team-elektron/WRO-FE-2026/Robot Photos/back.jpg

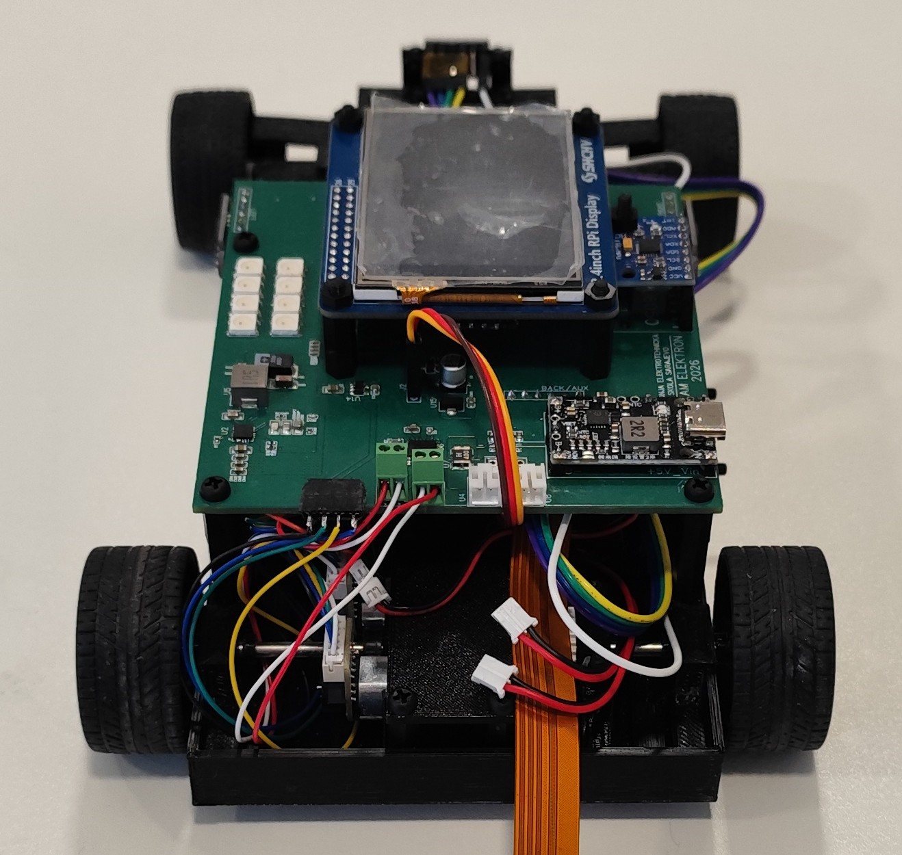
Robot Photos/back.jpg
