team-elektron/WRO-FE-2026/Robot Photos/bottom.jpg

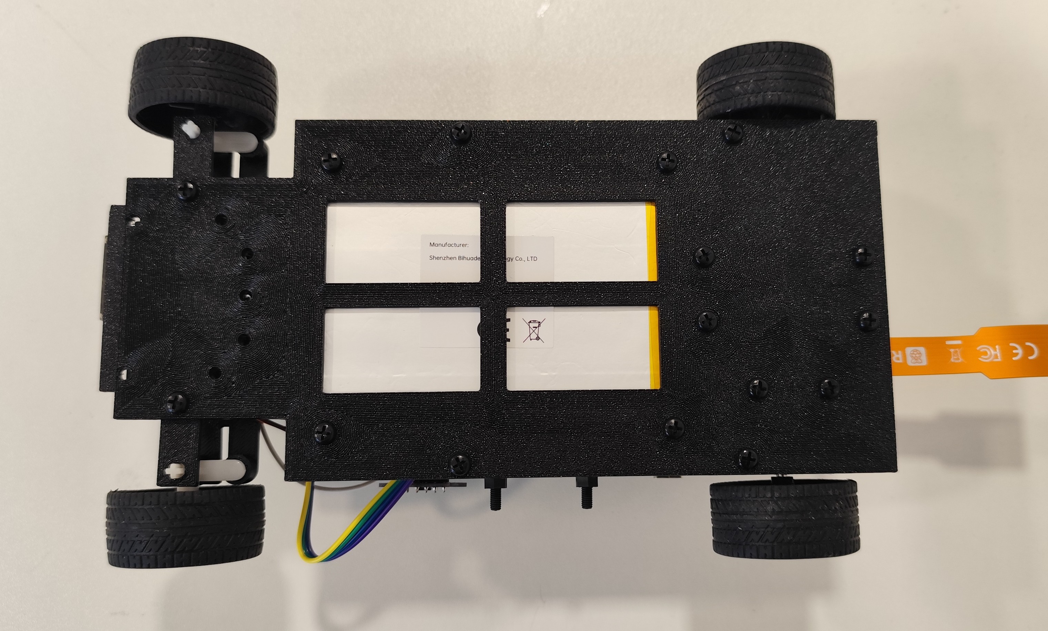
Robot Photos/bottom.jpg
