team-elektron/WRO-FE-2026/Robot Photos/front.jpg

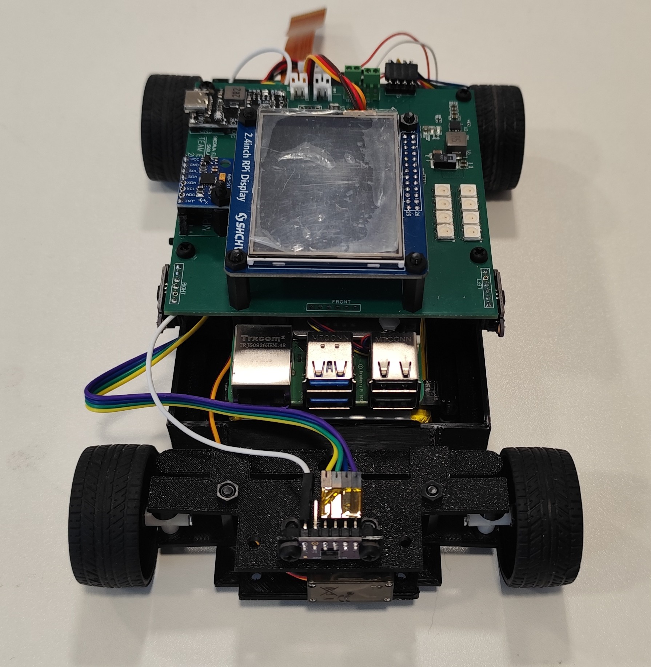
Robot Photos/front.jpg
