team-elektron/WRO-FE-2026/Robot Photos/left.jpg

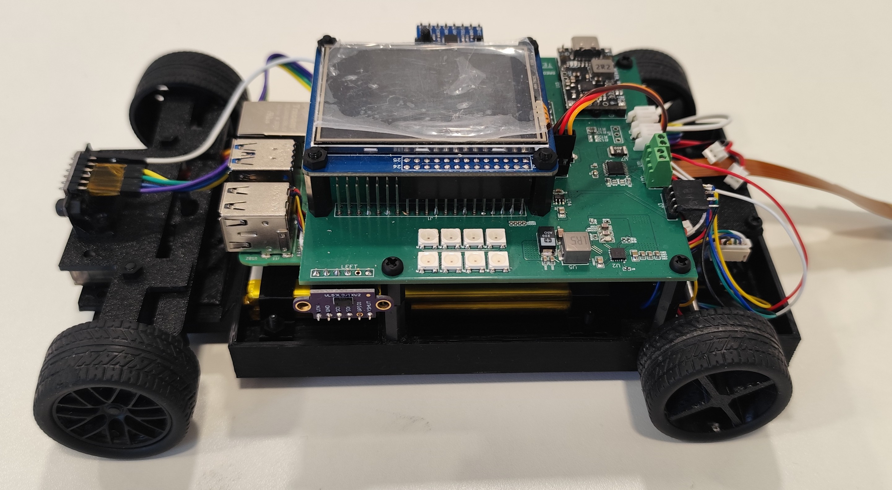
Robot Photos/left.jpg
