team-elektron/WRO-FE-2026/Robot Photos/Pics/3d-design-right.jpg

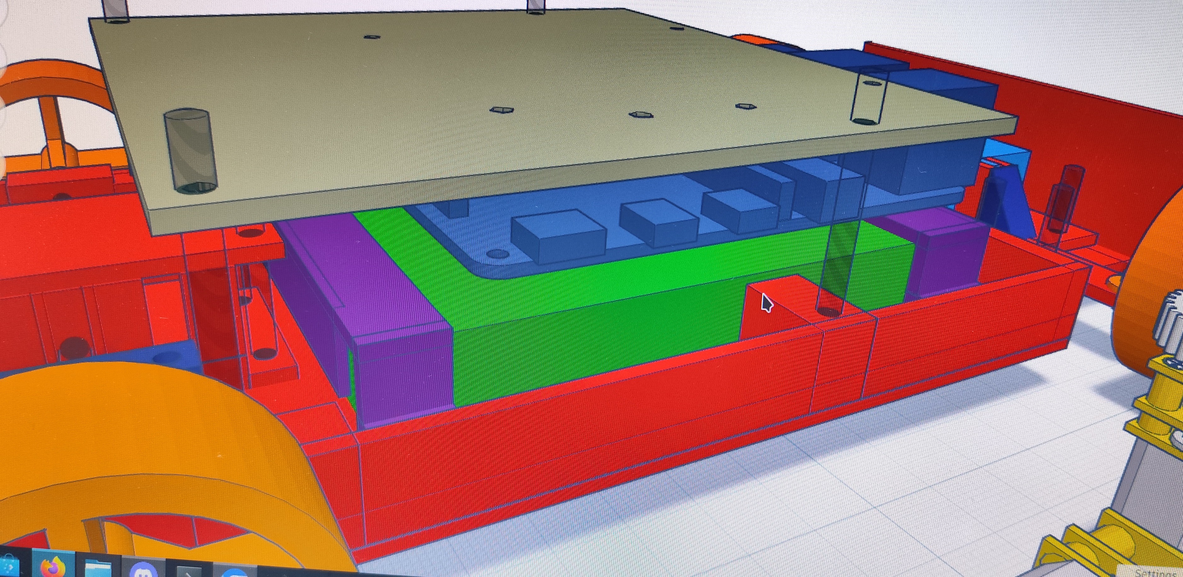
Robot Photos/Pics/3d-design-right.jpg
