team-elektron/WRO-FE-2026/Robot Photos/Pics/bat-chg-prot.png

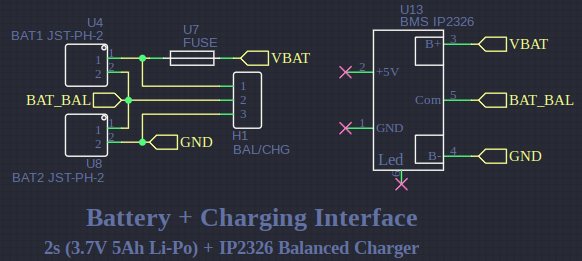
Robot Photos/Pics/bat-chg-prot.png
