team-elektron/WRO-FE-2026/Robot Photos/Pics/IMG_20260430_230106.jpg

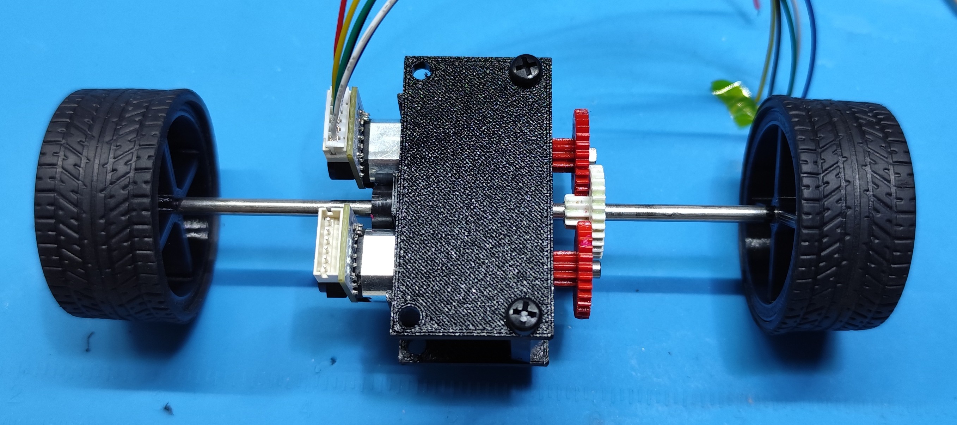
Robot Photos/Pics/IMG_20260430_230106.jpg
