team-elektron/WRO-FE-2026/Robot Photos/Pics/ip2326-and-mpu6050.jpg

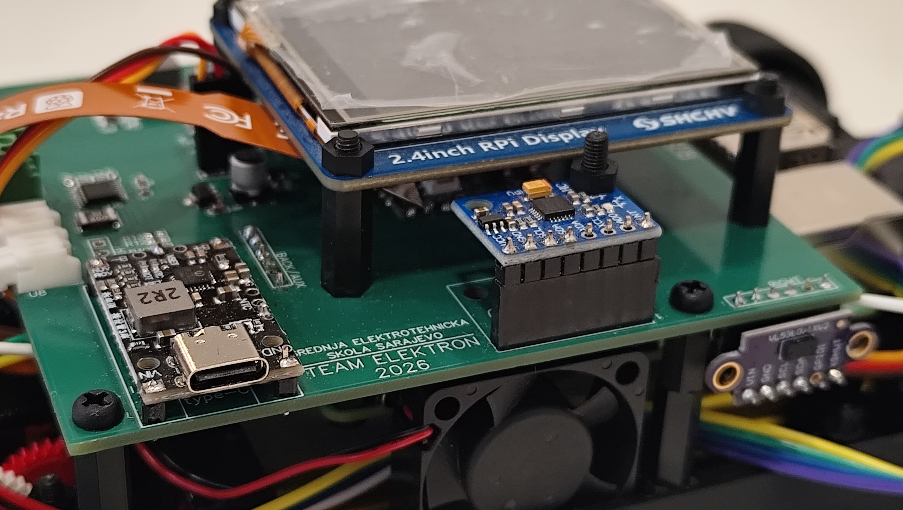
Robot Photos/Pics/ip2326-and-mpu6050.jpg
