team-elektron/WRO-FE-2026/Robot Photos/Pics/raspberry-pi-pico2.jpg

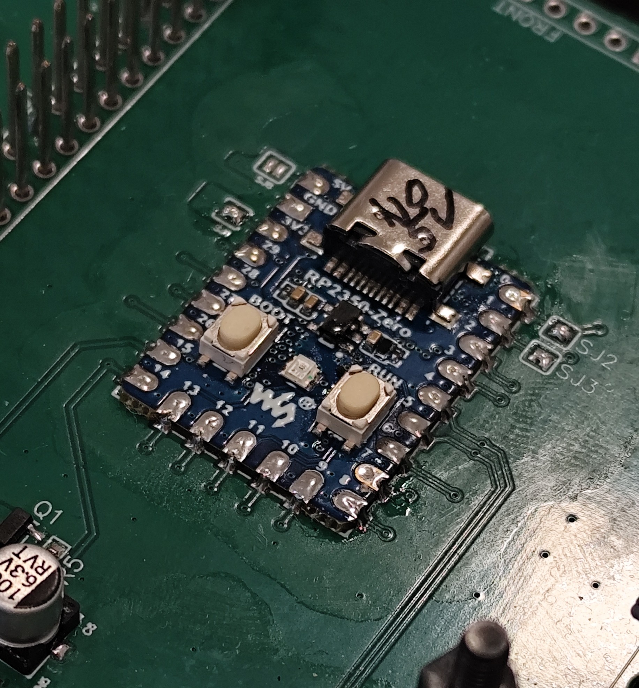
Robot Photos/Pics/raspberry-pi-pico2.jpg
