team-elektron/WRO-FE-2026/Robot Photos/top.jpg

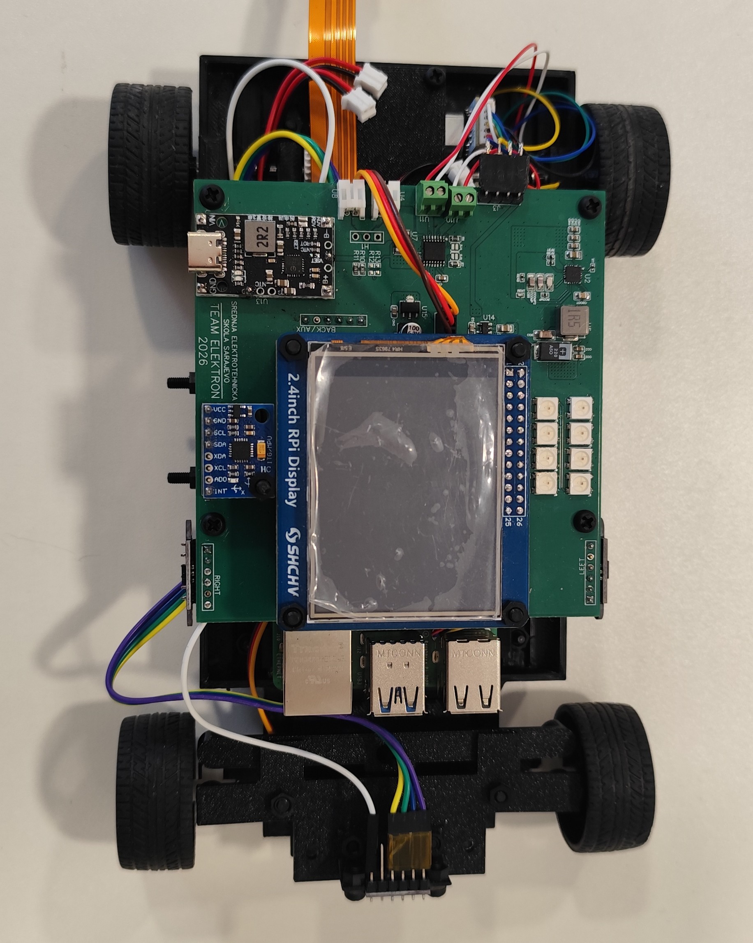
Robot Photos/top.jpg
