team-elektron/WRO-FE-2026/Team Photos/funny.jpg

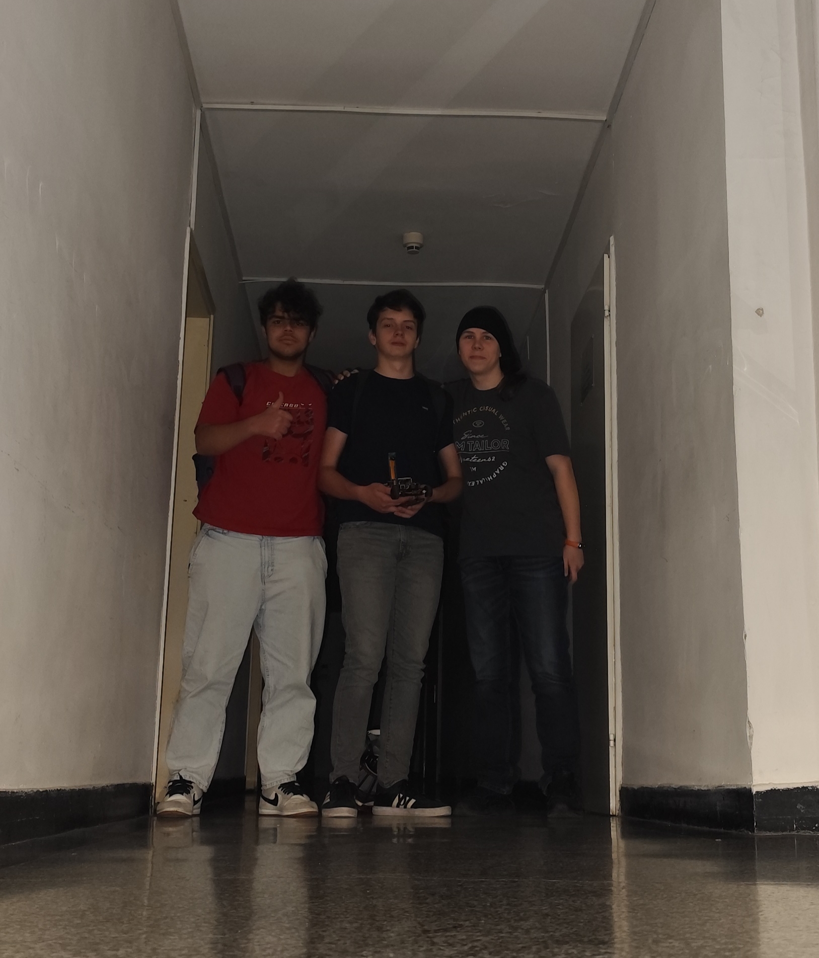
Team Photos/funny.jpg
