team-elektron/WRO-FE-2026/Schematics/BOM_WRO-FE-2026.csv

ID | Name | Designator | Footprint | Quantity | Manufacturer Part | Manufacturer | Supplier | Supplier Part | Price
1 | 105kΩ | RENT | R0402 | 1 | 0402WGF1053TCE | UNI-ROYAL(厚声) | LCSC | C25742 | 0.001
2 | 10kΩ | RFBB | R0402 | 1 | RC0402FR-7W10KL | YAGEO(国巨) | LCSC | C851848 | 0.003
3 | RP2040-ZERO | U3 | COMM-SMD_RP2040-ZERO | 1 | RP2040-Zero | Waveshare(微雪电子) | LCSC | C5350143 | 6.019
4 | ME6118A50PG | U15 | SOT-89-3_L4.5-W2.5-P1.50-LS4.2-BR | 1 | ME6118A50PG | MICRONE(南京微盟) | LCSC | C2835802 | 0.076
5 | AP2112K-3.3TRG1(MS) | U14 | SOT-23-5_L2.9-W1.6-P0.95-LS2.7-BR | 1 | AP2112K-3.3TRG1(MS) | MSKSEMI(美森科) | LCSC | C22365427 | 0.075
6 | BMS IP2326 | U13 | LX-LISC-V1 IP2326 TDA | 1
7 | MOTOR2 | U11 | CONN-TH_DB125-2.54-2P-GN | 1 | DB125-2.54-2P-GN-S | DORABO(地博电气) | LCSC | C918120 | 0.236
8 | MOTOR1 | U10 | CONN-TH_DB125-2.54-2P-GN | 1 | DB125-2.54-2P-GN-S | DORABO(地博电气) | LCSC | C918120 | 0.236
9 | BAT2 JST-PH-2 | U8 | CONN-TH_S2B-PH-K-S-LF-SN | 1 | S2B-PH-K-S(LF)(SN) | JST | LCSC | C173752 | 0.038
10 | FUSE | U7 | F1812 | 1 | BSMD1812-400-12V | BHFUSE(佰宏) | LCSC | C18164540 | 0.132
11 | DRV8833PWP | U6 | TSSOP-16_L5.0-W4.4-P0.65-LS6.4-BL-EP | 1 | DRV8833PWPR | TI(德州仪器) | LCSC | C50506 | 0.924
12 | 1.5uH | U5 | IND-SMD_L7.2-W6.6_GPSR07X0 | 1 | CYA0650-1.5UH | SHOU HAN(首韩) | LCSC | C5189751 | 0.26
13 | BAT1 JST-PH-2 | U4 | CONN-TH_S2B-PH-K-S-LF-SN | 1 | S2B-PH-K-S(LF)(SN) | JST | LCSC | C173752 | 0.038
14 | TPS54623RHLR | U2 | VQFN-14_L3.5-W3.5-P0.50-TL-EP_TPS54622RHLT | 1 |  | TI(德州仪器) | LCSC | C560970 | 0.503
15 | NC | SJ8,SJ3,SJ2 | SJ_2S | 3
16 | NO | SJ5,SJ4,SJ1 | SJ_2S-NO | 3
17 | 53.6kΩ | RT | R0402 | 1 | RC0402FR-0753K6L | YAGEO(国巨) | LCSC | C273330 | 0.001
18 | VL53L0x_3 | RIGHT | HDR-F-2.54_1X6 | 1 |  |  | LCSC | C40877 | 0.088
19 | 75kΩ | RFBT | R0402 | 1 | CRCW040275K0FKED | VISHAY(威世) | LCSC | C482234 | 0.004
20 | 37.4kΩ | RENB | R0402 | 1 | RC0402FR-0737K4L | YAGEO(国巨) | LCSC | C185422 | 0.001
21 | 7.5kΩ | RCOMP | R0402 | 1 | CRCW04027K50FKED | VISHAY(威世) | LCSC | C482236 | 0.004
22 | 10kΩ | R13,R10,R5 | R0603 | 3 | RC0603FR-0710KL | YAGEO(国巨) | LCSC | C98220 | 0.002
23 | 36kΩ | R12,R11 | R0603 | 2 | RC0603FR-0736KL | YAGEO(国巨) | LCSC | C114619 | 0.002
24 | 200mΩ | R7,R6 | R0603 | 2 | RTT03R20JTP | RALEC(旺诠) | LCSC | C158890 | 0.003
25 | IRLML6344 | Q1 | SOT-23-3_L3.0-W1.6-P1.90-LS2.8-BR | 1 | IRLML6344TR(UMW) | UMW(友台半导体) | LCSC | C5271195 | 0.024
26 | VL53L0x_2 | LEFT | HDR-F-2.54_1X6 | 1 |  |  | LCSC | C40877 | 0.088
27 | WS2812E-V5 | LED9,LED8,LED7,LED6,LED5,LED4,LED3,LED2 | LED-SMD_4P-L5.0-W5.0-LS5.4-TL-1 | 8 | WS2812E-V5 | worldsemi | LCSC | C2920042 | 0.064
28 | MOTOR_HALL | J3 | HDR-M-2.54_1X4 | 1 |  |  | LCSC | C124378 | 0.055
29 | SERVO | J2 | HDR-M-2.54_1X3 | 1 |  |  | LCSC | C180248 | 0.214
30 | 40P_GPIO | J1 | HDR-M-2.54_2X20 | 1 |  |  | LCSC | C50980 | 0.224
31 | BAL/CHG | H1 | HDR-F-2.54_1X3 | 1 |  |  | LCSC | C146690 | 0.098
32 | VL53L0x_1 | FRONT | HDR-F-2.54_1X6 | 1 |  |  | LCSC | C40877 | 0.088
33 | 2.2nF | CSS | C0805 | 1 | CL21C222JBFNNNE | SAMSUNG(三星) | LCSC | C28260 | 0.03
34 | 100nF | CO9,CO8,CO7,C10,C2 | C0402 | 5 | CGA0402X7R104K6R3GT | HRE(芯声) | LCSC | C22435938 | 0.001
35 | 100uF | CO6 | C1206 | 1 | TCC1206X5R107M6R3HT | CCTC(三环) | LCSC | C380356 | 0.061
36 | 10uF | CO3,CO2,C3,C1 | C0603 | 4 | CL10X106MQ8NNNC | SAMSUNG(三星) | LCSC | C318634 | 0.015
37 | 220uF | CO1 | CAP-SMD_L7.3-W4.3 | 1 | 10TPE220ML | PANASONIC(松下) | LCSC | C147767 | 0.901
38 | 10uF | CIN5,CIN3,CIN2,CIN1 | C0603 | 4 | CL10A106MP8NNNC | SAMSUNG(三星) | LCSC | C85713 | 0.012
39 | 4.7uF | CIN4,C4 | C0805 | 2 | TMK212BBJ475MD-T | TAIYO YUDEN(太诱) | LCSC | C650989 | 0.074
40 | 27pF | CCOMP2 | C0805 | 1 | CC0805JRNPO9BN270 | YAGEO(国巨) | LCSC | C107113 | 0.007
41 | 4.7nF | CCOMP | C0805 | 1 | CGA4C2C0G1H472JT0Y0N | TDK | LCSC | C338091 | 0.049
42 | 100nF | CBOOT | C0805 | 1 | C0805C104K3RACTU | KEMET(基美) | LCSC | CL21B104KBCNNNC
43 | 100uF | C6 | CAP-SMD_BD5.0-L5.3-W5.3-RD | 1 | RVT0J101M0505 | ROQANG(容强) | LCSC | C72472 | 0.03
44 | VL53L0x_4 | BACK/AUX | HDR-F-2.54_1X6 | 1 |  |  | LCSC | C40877 | 0.088
45 | MPU6050_edit | 1 | MPU6050 | 1
