team-elektron/WRO-FE-2026/Robot Photos/Pics/parts-pile.jpg

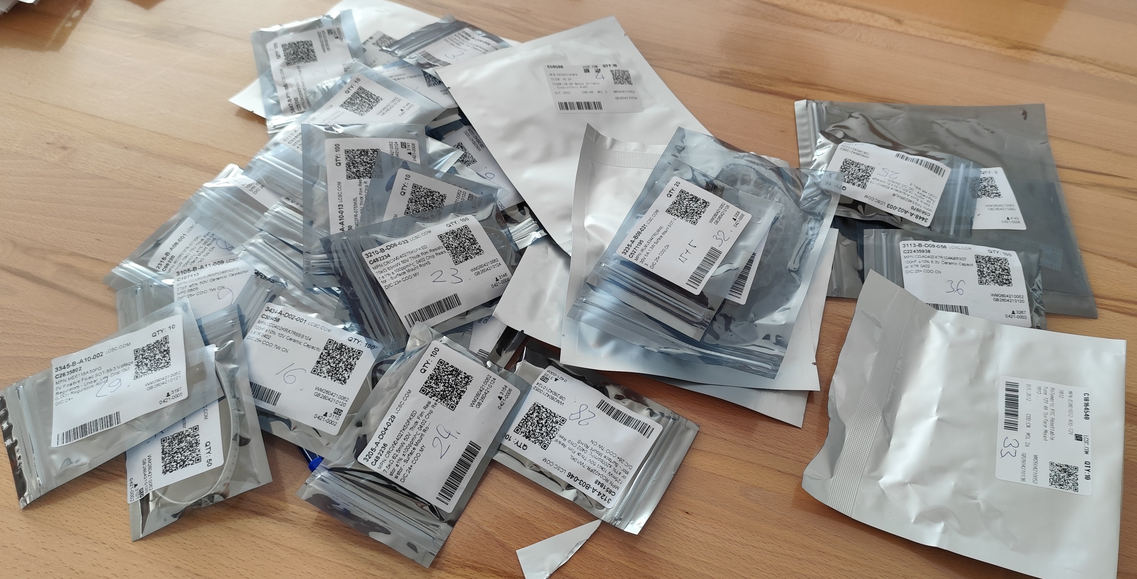
Robot Photos/Pics/parts-pile.jpg
