team-elektron/WRO-FE-2026/3D Models/Chassis/Chassis Main.stl

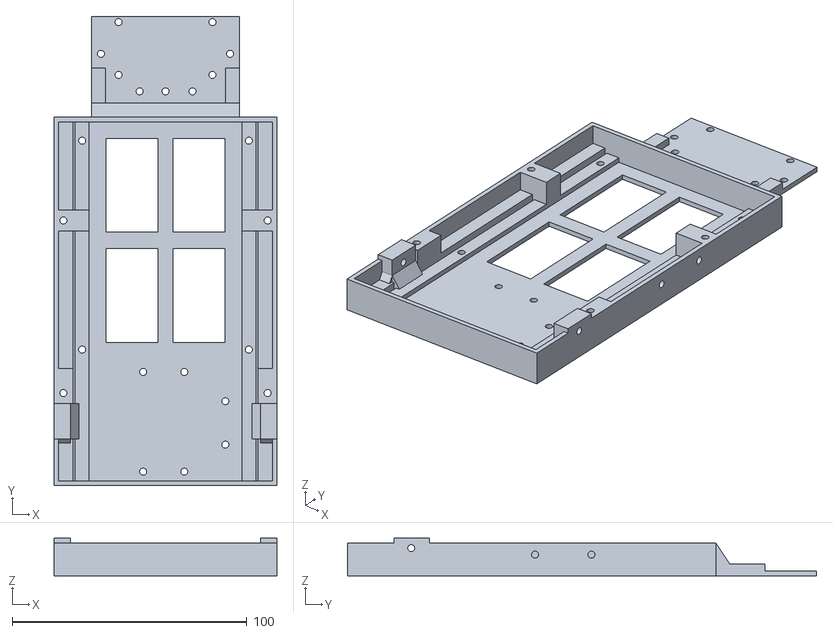
[picture p42: CAD file, 2026-05-27]
3D Models/Chassis/Chassis Main.stl
95.0 x 200.0 x 16.0
