team-elektron/WRO-FE-2026/3D Models/Camera Holder/Cam Holder v2.stl

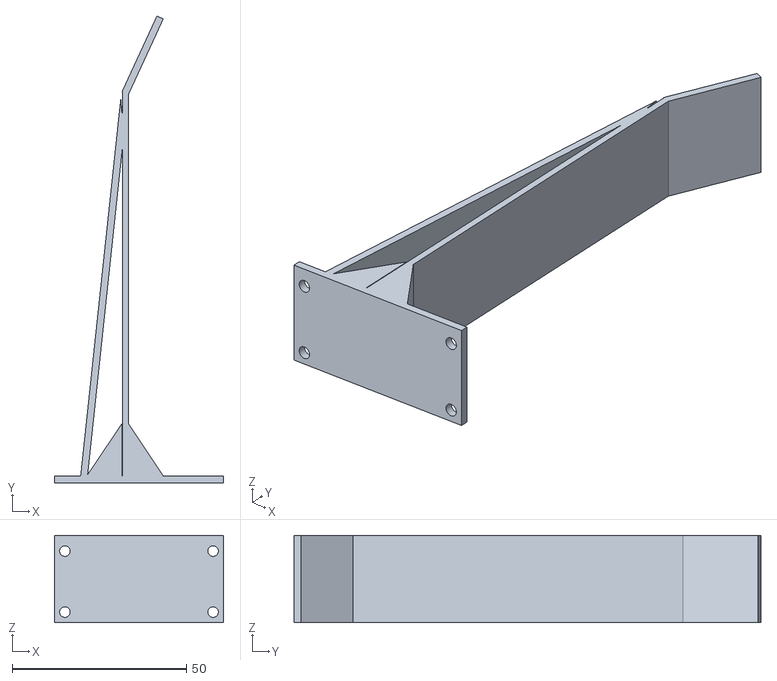
[picture p43: CAD file, 2026-05-27]
3D Models/Camera Holder/Cam Holder v2.stl
48.5 x 133.9 x 25.0
