team-elektron/WRO-FE-2026/3D Models/Chassis/Battery/Battery Holder 1.stl

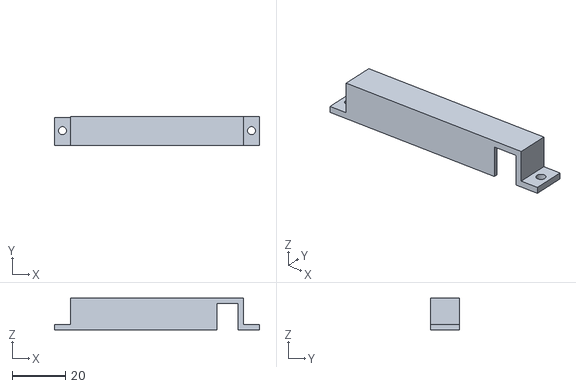
[picture p44: CAD file, 2026-05-27]
3D Models/Chassis/Battery/Battery Holder 1.stl
77.0 x 10.8 x 12.0
