team-elektron/WRO-FE-2026/3D Models/Main Motor Assembly/Top Case.stl

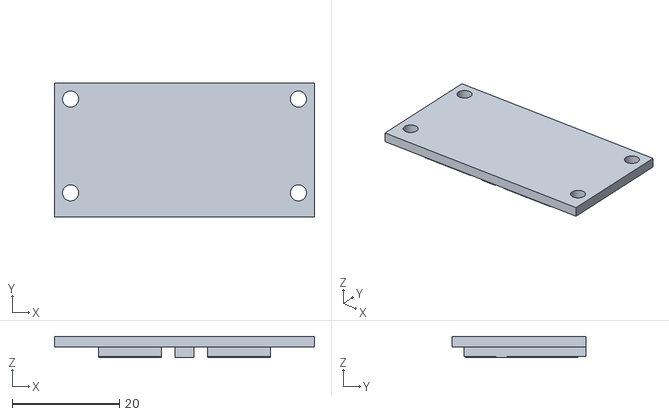
[picture p45: CAD file, 2026-05-01]
3D Models/Main Motor Assembly/Top Case.stl
48.5 x 25.0 x 4.00
