team-elektron/WRO-FE-2026/3D Models/Steering Mechanism/Base.stl

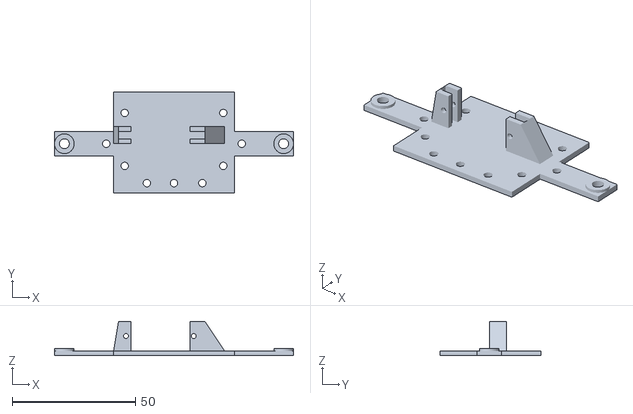
[picture p46: CAD file, 2026-05-30]
3D Models/Steering Mechanism/Base.stl
97.0 x 41.0 x 14.0
