team-elektron/WRO-FE-2026/3D Models/Wheels/Rear Wheel.stl

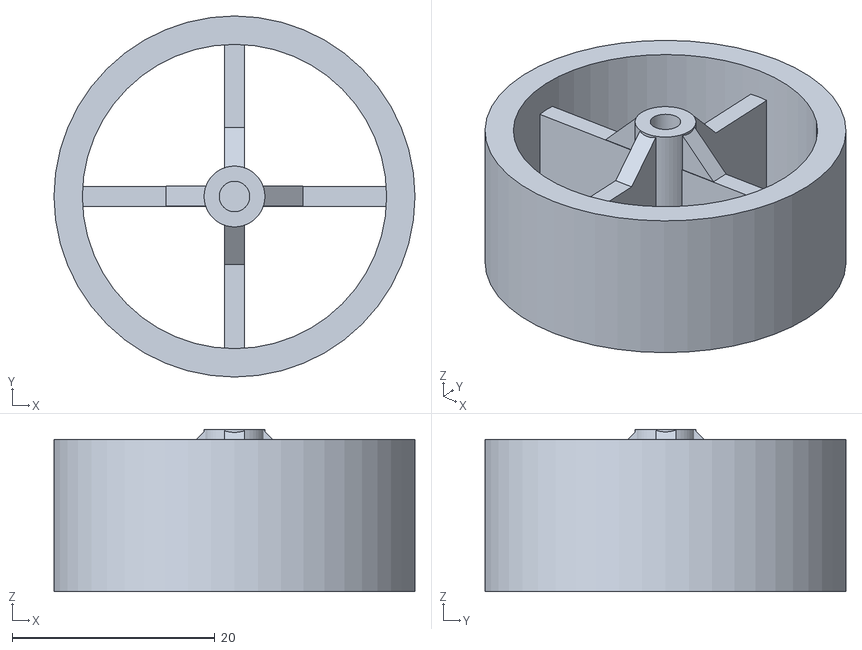
[picture p47: CAD file, 2026-05-01]
3D Models/Wheels/Rear Wheel.stl
35.6 x 35.6 x 16.0
