team-elektron/WRO-FE-2026/3D Models/Chassis/Battery/Battery Holder 2.stl

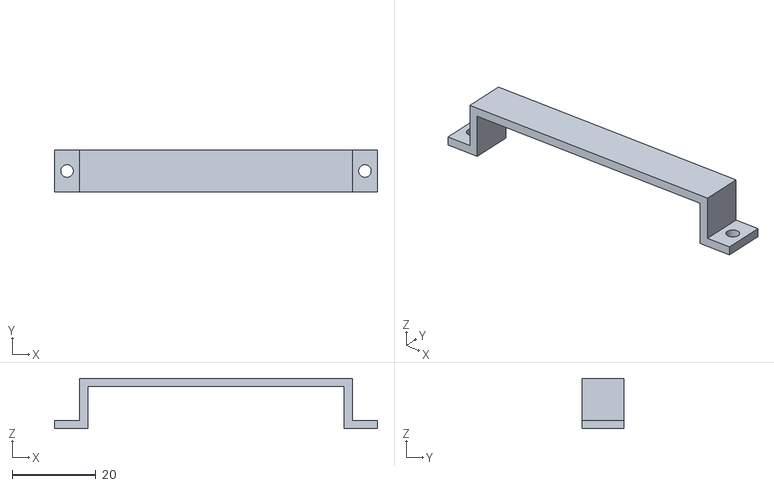
[picture p48: CAD file, 2026-05-27]
3D Models/Chassis/Battery/Battery Holder 2.stl
77.0 x 10.0 x 12.0
