team-elektron/WRO-FE-2026/3D Models/Main Motor Assembly/Bottom Case.stl

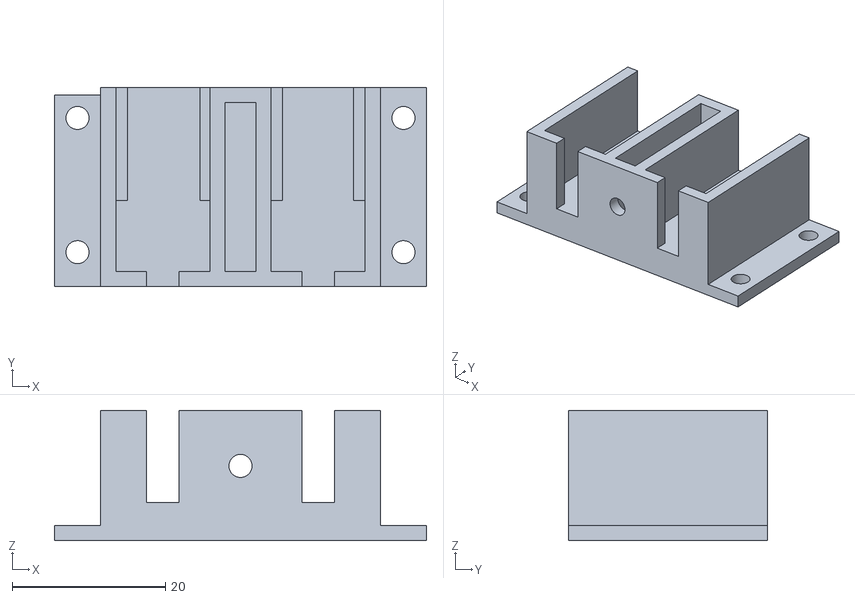
[picture p49: CAD file, 2026-05-01]
3D Models/Main Motor Assembly/Bottom Case.stl
48.5 x 26.0 x 17.0
