team-elektron/WRO-FE-2026/3D Models/Steering Mechanism/Top.stl

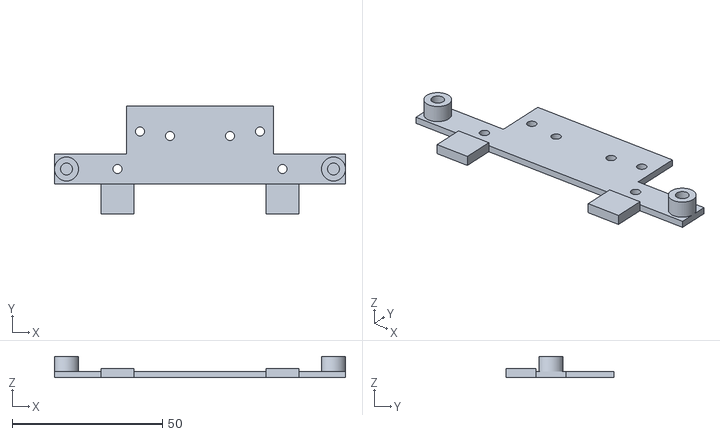
[picture p50: CAD file, 2026-05-30]
3D Models/Steering Mechanism/Top.stl
97.0 x 36.0 x 7.00
