team-elektron/WRO-FE-2026/3D Models/Steering Mechanism/Steer Axle.stl

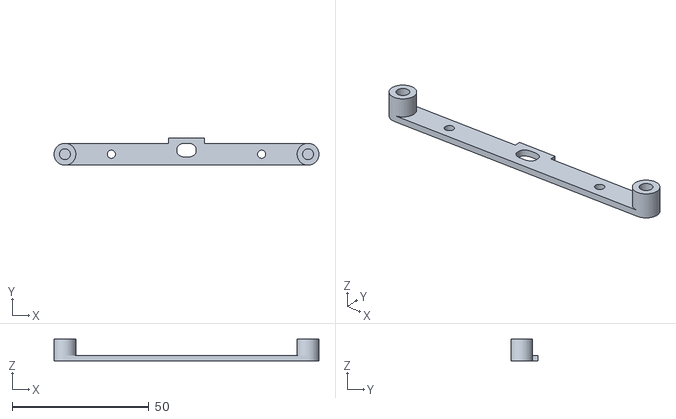
[picture p51: CAD file, 2026-05-27]
3D Models/Steering Mechanism/Steer Axle.stl
97.0 x 10.0 x 8.00
