team-elektron/WRO-FE-2026/3D Models/Steering Mechanism/ToF Sensor Mount.stl

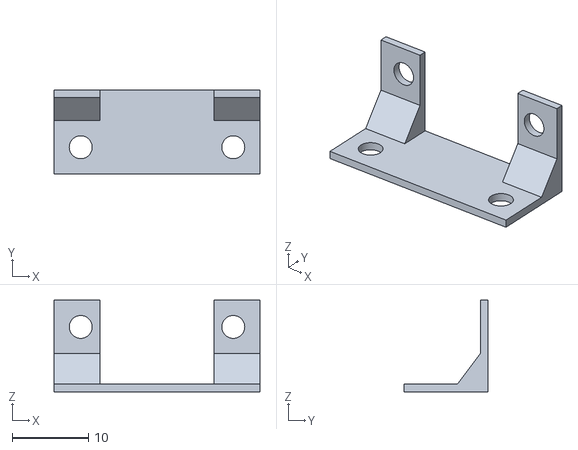
[picture p52: CAD file, 2026-05-27]
3D Models/Steering Mechanism/ToF Sensor Mount.stl
27.0 x 11.0 x 12.0
