team-elektron/WRO-FE-2026/Robot Photos/Pics/inital-assembly-2.jpg

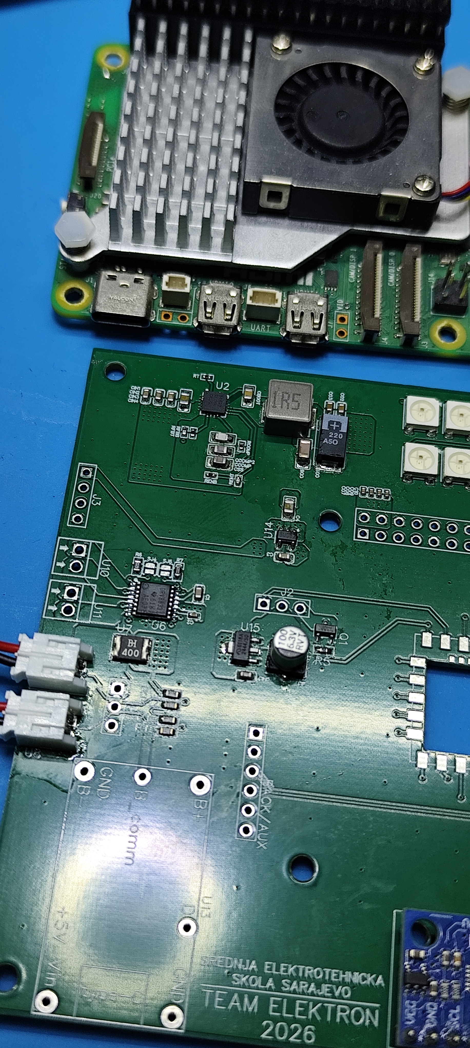
Robot Photos/Pics/inital-assembly-2.jpg
