team-elektron/WRO-FE-2026/Robot Photos/Pics/first-test-after-assy.jpg

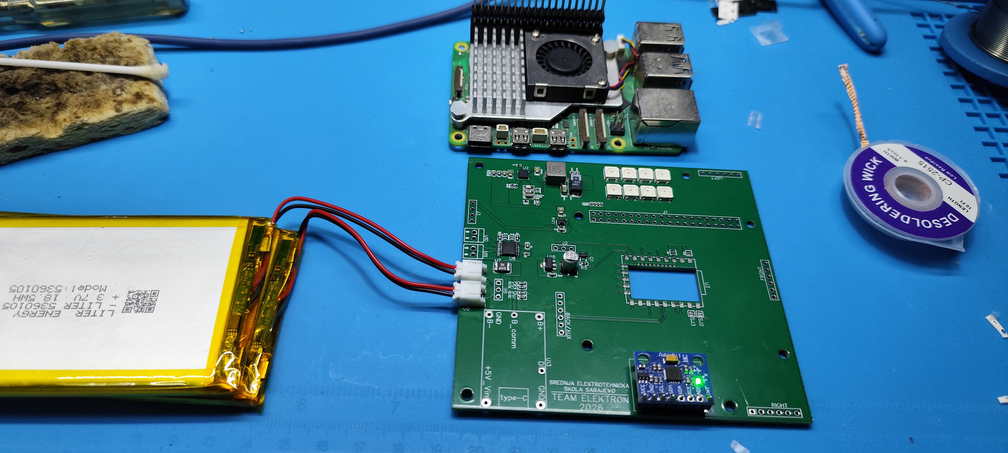
Robot Photos/Pics/first-test-after-assy.jpg
