team-elektron/WRO-FE-2026/Schematics/Schematic_WRO-FE-2026.pdf

# GPIO Interface

# Battery + Charging Interface

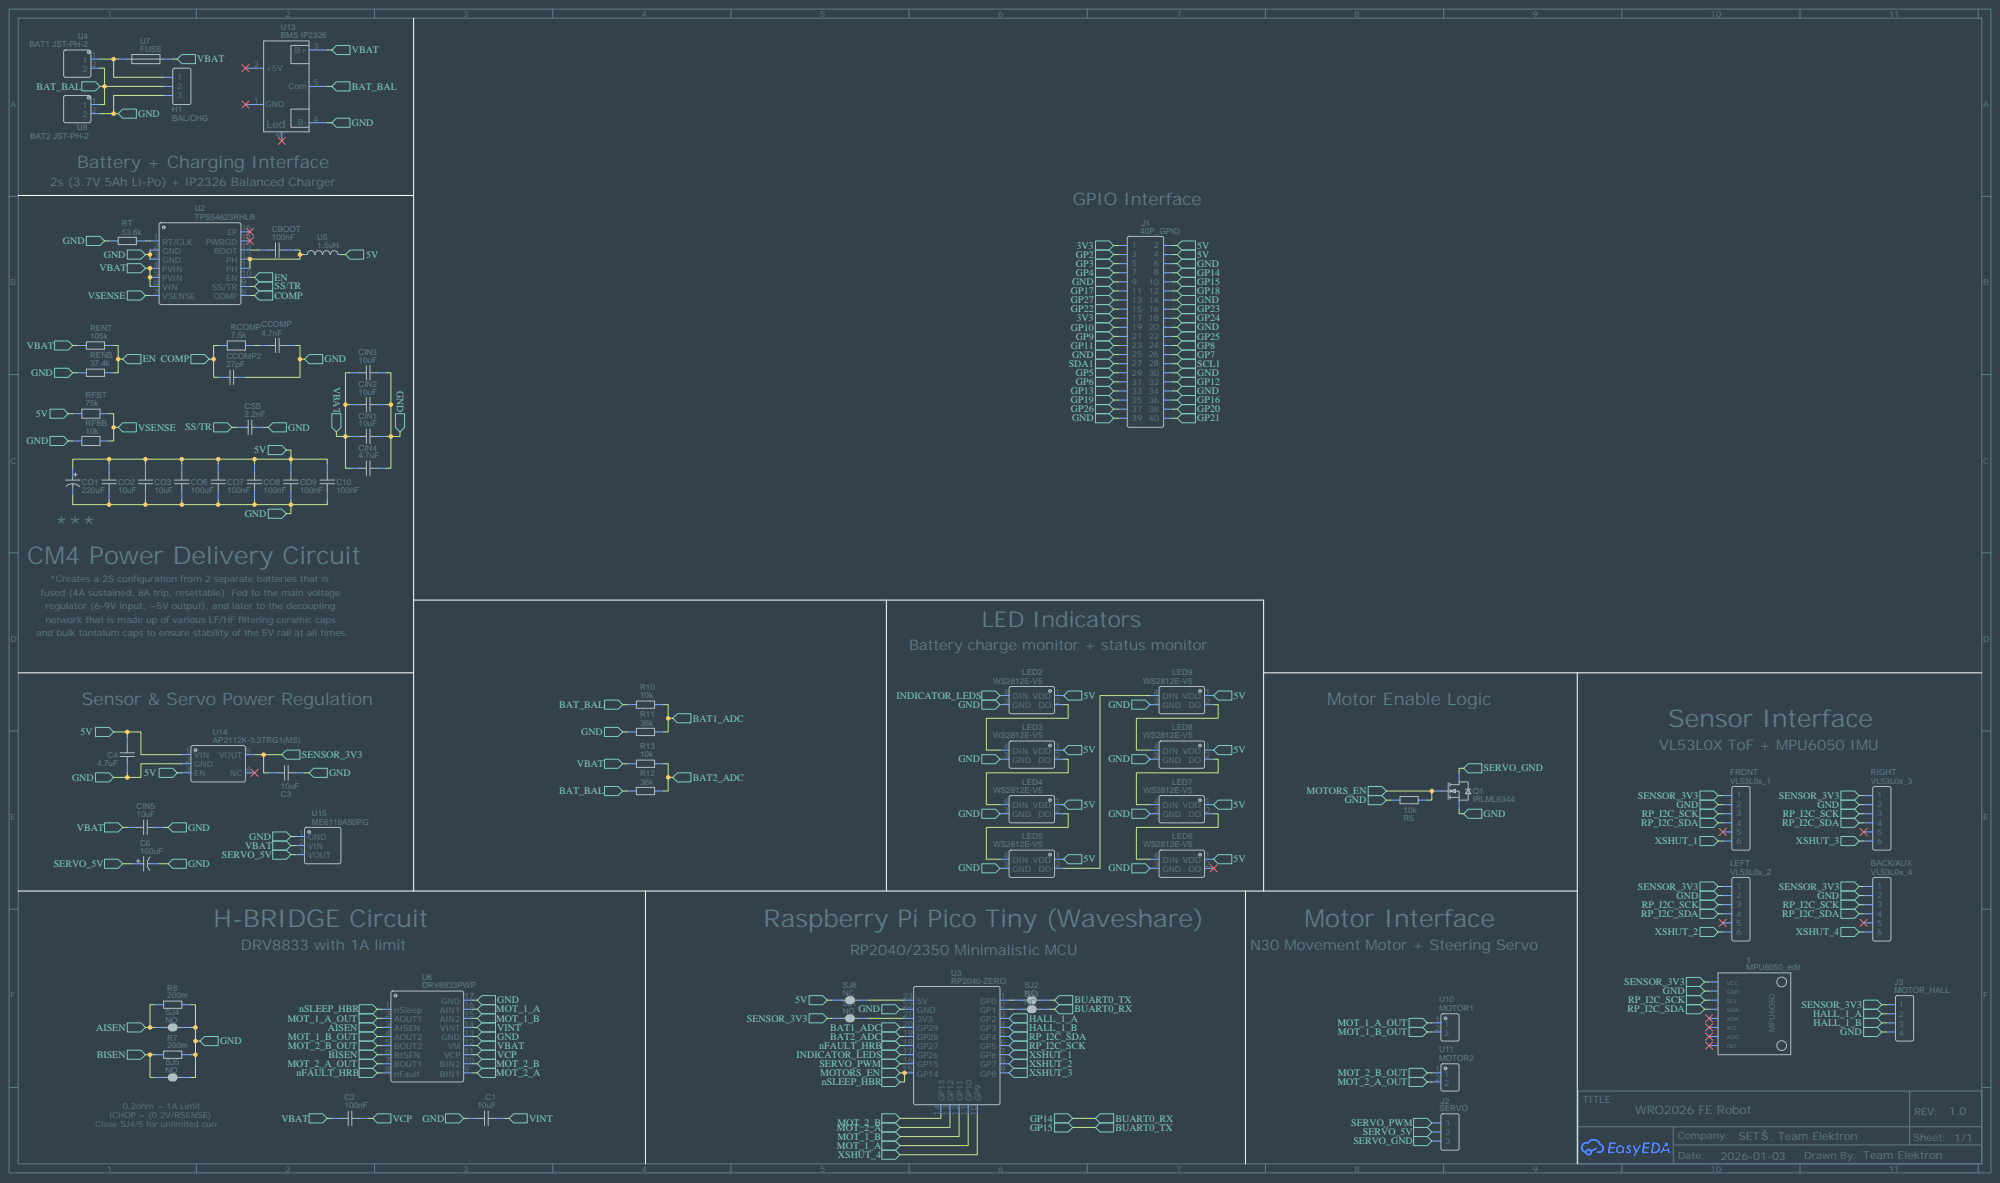
[picture p55: page 1]

2s (3.7V 5Ah Li-Po) + IP2326 Balanced Charger

TPS54623RHLR
EN 10 PH 11 PH 12 BOOT 13 PWRGD 14 EP 15

*Creates a 2S configuration from 2 separate batteries that is
fused (4A sustained, 8A trip, resettable). Fed to the main voltage
regulator (6-9V input, ~5V output), and later to the decoupling
network that is made up of various LF/HF filtering ceramic caps
and bulk tantalum caps to ensure stability of the 5V rail at all times.

Battery charge monitor + status monitor

Raspberry Pi Pico Tiny (Waveshare)

N30 Movement Motor + Steering Servo

0.2ohm = 1A Limit
ICHOP = (0.2V/RSENSE)
Close SJ4/5 for unlimited curr.

Company: SET , Team Elektron

Drawn By: Team Elektron
