team-elektron/WRO-FE-2026/Code/pico2-pi5 bridge/encoder.h

#pragma once
#include <stdint.h>

#define COUNTS_PER_REV  375

void     encoder_init();
void     encoder_reset();
int32_t  encoder_get_ticks();
float    encoder_get_rpm(float dt_s);   // always positive magnitude
