team-elektron/WRO-FE-2026/(commit log)

2026-05-01 Add wheel designs #1
    [Rear Wheel.stl]
2026-05-15 Revise power delivery details and specifications
    Updated power delivery section with detailed specifications and components used for the robot's power management.
2026-05-15 Update README with power regulator details and images
    Added images and details about power regulators used in the robot.
2026-05-15 Revise README with driving system and power details
    Updated the driving system section with detailed motor specifications and configurations, added images, and refined the power delivery explanation.
2026-05-15 Refactor README by removing component list section
    Removed the component list section and adjusted the steering system description for clarity.
2026-05-15 Document UART protocol for Pi 5 and Pico 2 Zero
    Added details about UART communication protocol between Pi 5 and Pico 2 Zero, including packet structure and message types.
2026-05-15 Remove hardware specifications from README
    Removed hardware specifications for Raspberry Pi and sensors.
2026-05-15 Document sensors used in robot
    Added section about sensors used in the robot, including Time-of-Flight distance sensors and MPU6050 IMU sensor.
2026-05-16 Revise images and add assembly and code sections
    Updated image sizes and added sections for assembly process and code explanation.
2026-05-16 Add Raspberry Pi Camera Module 2 to components list
    Added Raspberry Pi Camera Module 2 to the list of components.
2026-05-27 Upload final schematics used for the competition
    [BOM_WRO-FE-2026.csv, PickAndPlace_PCB_WRO-FE-2026.csv]
2026-05-27 Upload final 3d designs
    [Battery Holder 1.stl, Battery Holder 2.stl, Cam Holder v2.stl, Chassis Main.stl]
2026-05-27 Add final steering mechanism design
    [Steer Axle.stl, ToF Sensor Mount.stl, Top.stl]
2026-05-29 Enhance README with Raspberry Pi Pico 2 communication details
    Added section for Raspberry Pi Pico 2 to Pi 5 communications bridge in the README.
2026-05-29 Update README with Bill of Materials section
    Added Bill of Materials section with links to components.
2026-05-29 Revise README sections and add Bill of Materials
    Updated the README to include detailed sections on the Bill of Materials, assembly process, and wiring.
2026-05-29 Add comms flowchart
2026-05-29 Fix image source in README for flowchart
2026-05-30 Minor fixes in tolerances
    [Base.stl, Top.stl]
2026-05-30 Enhance README with detailed assembly information
    Expanded the 3D Print & Assembly section with detailed descriptions of the robot's chassis, driving body, and steering mechanism, including material specifications and design improvements.
2026-05-30 Update README with steering mechanism details
    Added details about the steering mechanism components and materials used.
2026-05-30 Revise BOM and enhance assembly process description
    Updated the Bill Of Materials section and expanded the assembly process details, including PCB assembly and 3D printing.
2026-05-30 Enhance README with PCB assembly details and image updates
    Updated image width for drive mechanism illustration and added details about PCB assembly process.
2026-05-30 Enhance README with team info and image adjustments
    Added team introduction and photo, and updated PCB image sizes.
2026-05-30 Adjust image widths in PCB assembly section
    Updated image widths in PCB assembly section for better layout.
2026-05-30 Revise navigation for assembly process and improvements
    Updated navigation links in the README to reflect changes in sections.
2026-05-30 Update README with assembly video link
    Added a link to a video demonstrating the assembly process.
